JohnTT/ECECapstone2018/Reports/Design Reviews/G07_DR2.pdf

Group 7

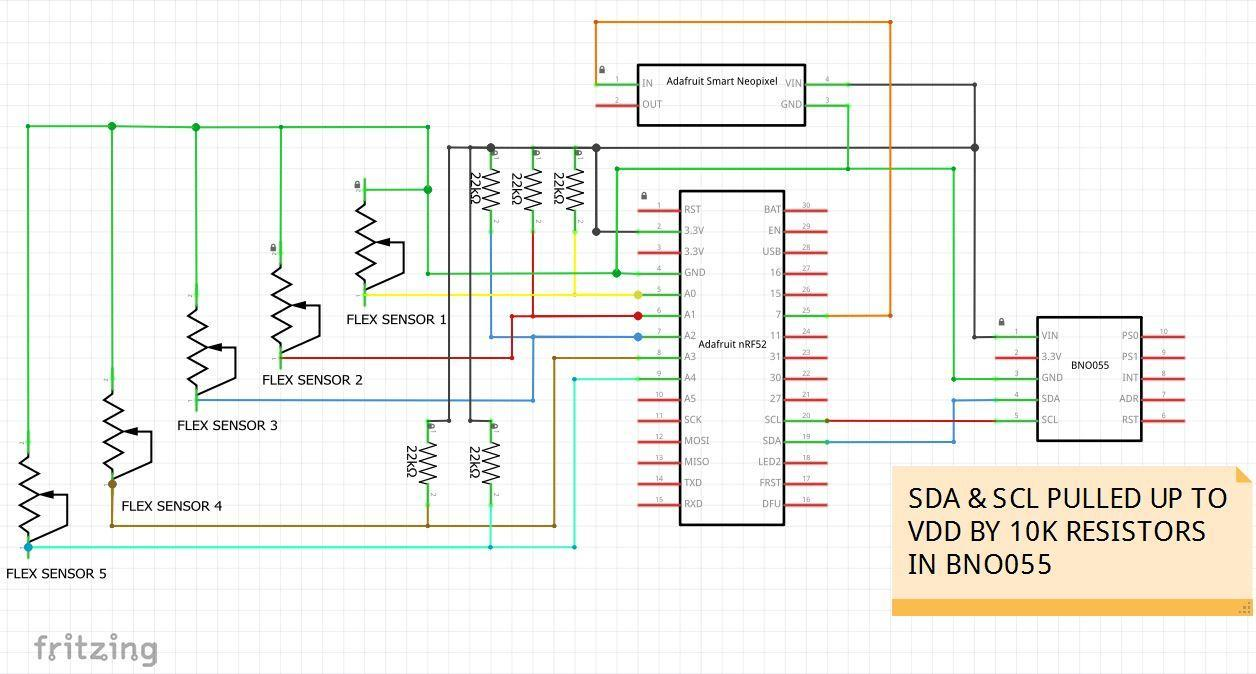
[picture p1: figure]

1

Air Mouse: Wireless translation of hand gestures into two and three-dimensional mouse movements

Summary of Progress

The goal of this project is to make a wearable glove that connects as a mouse to any computer, laptop or cell phone device that supports the Bluetooth 4.0 Low Energy Standard. The first step in the design process was to create a general layout of the components showing their connections to the microcontroller. Figure 1 shows the electrical schematic design. The team tested and studied the ordered hardware components to finalize the mechanisms of each feature on the Air Mouse. The scope of the project includes the wireless transmission of data which the Feather nRF52 Bluefruit LE board satisfies since it contains a Bluetooth transceiver.

Figure 1 Electrical Schematic for Air Mouse

The BNO055 was mounted on a breadboard and tested to record the angular displacement due to movement away from the calibrated start position. It uses three triple-axis sensors: an accelerometer, a gyroscope, and a magnetometer. The BNO055 filters and synthesizes the sensor data on its built in microprocessor which runs a fusion algorithm to give the relative orientation as a vector of three Euler angles. We selected the return in the form of Euler angles, since it is the easiest to visualize and manipulate. The sensor interfaces with nRF52 over I²C serial communication and the nRF52 streams the data to the computer over Bluetooth. The relative position is taken and converted to cursor speed and direction. For testing purposes, we used a flex sensor to set the start position of the breadboard. This was stored in the memory of the nRF52. Updated Euler angles are continually read from the BNO055 and the deviation of the updated angle from the starting angle returns the relative position of the breadboard. Figure 2 shows the resulting angles (+/-α) based on hand movements in the x-y plane.

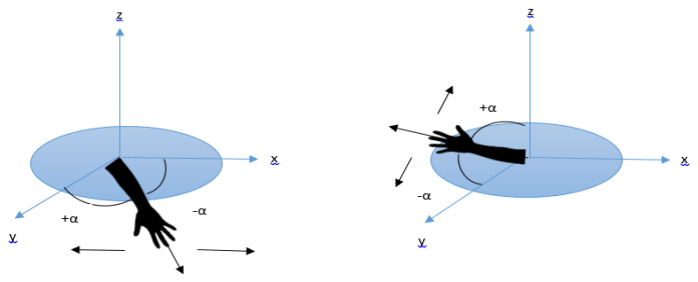
[picture p2: figure]

2

Figure 2 Movement of hand on x-y plane

The flex sensors allow for the mouse clicks by measuring the change in resistance due to bending the sensor. The sensors were measured by Hammed and Ibrahim using a digital multimeter. In their relaxed state, the sensors have a minimum resistance of 50 kΩ and a maximum flexion resistance of 224 kΩ. The change in resistance is communicated with the microcontroller in the form of voltage changes that are detected by the microcontroller on the analog pins 1 and 2. The measured voltages are divided into set thresholds to determine the level of flexion. This allows the flex sensors to aid in three dimensional applications as well such as a grabbing action. In addition to the flex sensors, the pressure sensitive sheets were also tested as an alternative mouse clicking action specifically designed for people with Carpal Tunnel syndrome. The sheets work on the same resistance change principle as the flex sensors. The relaxed state resistance of the sheets was measured on the multimeter to be 0.24 kΩ with a maximum of 8.4 kΩ depending on the pressure applied. .

The portable power source requirement is fulfilled in the form of a 3.7V LiPo Battery Cell which connects to a RGB Smart Neopixel used to display the battery status. Using the current discharge curve of the battery specified on the data sheet, an arbitrary color code was developed by Simran to display the remaining battery life for the Airmouse. The internal vbat pin on the microcontroller is constantly read to get the ADC readings ranging from 0 to 300mV with a 12 bit resolution. The vbat pin also has a resistor voltage divider that is taken into account to get the LiPo voltage readings in mV. The readings are further divided into arbitrary levels. The neopixels change color to inform the user each time the voltage and, hence, the battery level drops below those thresholds. The battery life specifications and optimization can be further worked on as the prototype develops.

Summary of Changes

Our current design uses a flex sensor on the top and pressure sensitive sheets on the bottom of each finger. Because these sensors are enough to perform multiple tasks of clicking as well as scrolling, we decided to remove the joystick to stay within space/weight constraints. The joystick was initially supposed to allow scrolling action.

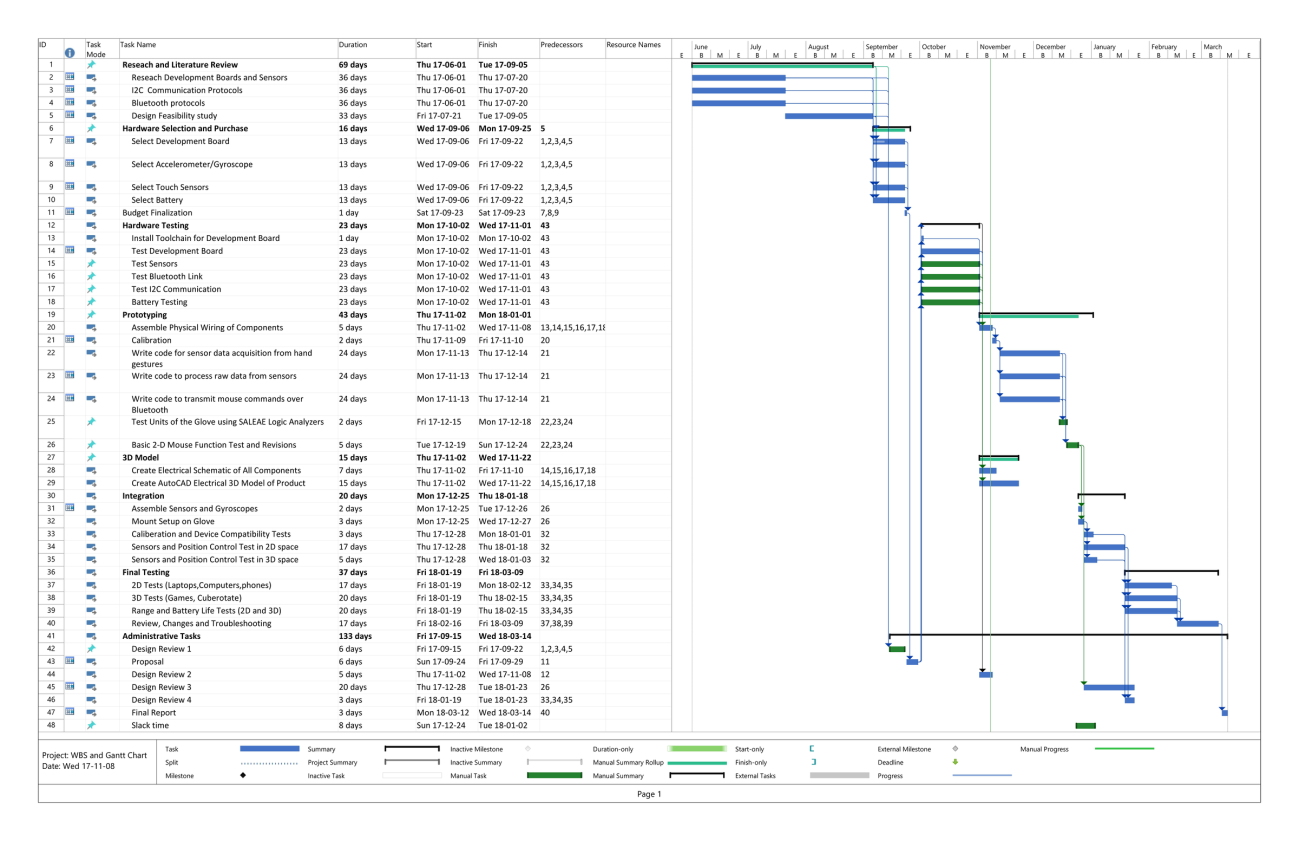
[picture p3: figure]

3

Schedule and Updated Gantt Chart

The team progress and the Gantt Chart tasks were largely in line with each other. The schedule was modified to include slack time in winter from December 24, 2017 to January 2, 2018 to account for winter holidays. This reduces the time for sensor data acquisition, processing of raw data and transmission code development from 31 to 24 days which we deem achievable. This also mandates the completion of basic two dimensional mouse features testing to be completed by December 24, 2017.
