JohnTT/ECECapstone2018/Reports/Design Reviews/G07_DR2Slide_v2.pdf

# AIRMOUSE

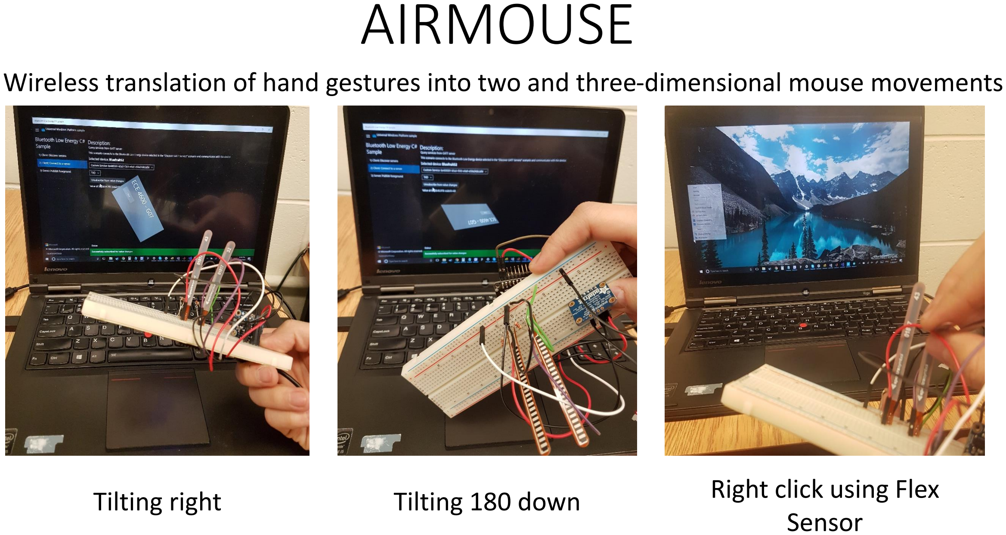
[picture p4: page 1]

Wireless translation of hand gestures into two and three-dimensional mouse movements

Tilting right | Tilting 180 down | Right click using Flex Sensor
