JohnTT/ECECapstone2018/Reports/Design Reviews/G07_DR3_V9.pdf

G07 - Air Mouse: Wireless translation of hand gestures into two and three-dimensional mouse movements

### 1.0 Summary of Progress towards Integration

The goal of this project is to make a wearable glove that connects as a mouse to any computer, laptop or cell phone device that supports the Bluetooth 4.0 Low Energy Standard. In line with the pre-established Gantt chart schedule, the project is in the integration stage.

A diagram was created to show the position of each component on a right-hand glove, and then the tested sub-systems were transferred from the breadboard onto the glove. The glove material was chosen using the following criterion:

- Lightweight (< 50g) to allow for unstrained hand movements.
- Antistatic Fabric to ensure against static electricity buildup.
- Air-permeable to reduce sweating or related discomfort.
A ready-to-wear right-hand glove made of cotton was chosen in standard unisex, medium size, for the prototype.

### 1.1 The layout of the glove was carefully planned and designed as follows:

The BNO055 sensor receives the hand orientation and tilt information based on Euler angle displacement from its initial position. To allow for maximum sensitivity to hand movements and gestures, it is mounted horizontally slightly before the knuckles area.

The Flex sensors are placed on the inner sides of the glove for more flexibility and to reduce the amount of pressure exerted on the fingers. A 33K Ohm resistor is attached in series with each flex sensor for this design, which gives a range of approximately 0.5V, from fully straight to fully flexed when tested. The threshold voltage for the pinky (A0), ring (A1), middle (A2) and index fingers (A3) were set to 1.8V, 2.5V, 2.0V, and 2.9V respectively. The numbers in brackets indicate which corresponding pin each sensor is connected to on the microcontroller. The state of each finger is read by the microcontroller, and flexing and relaxing certain fingers allows the user to perform mouse actions. This allows the microcontroller to distinguish between left and right mouse clicks depending on which finger is flexed. Flexing all fingers at once puts the mouse in scrolling mode.

The Battery is mounted between the thumb finger and wrist area. The Neopixel is placed beside it to indicate the battery life remaining with the intensity of the status indicator lamp. The brightness indicates the power level of the battery, with a green color light displaying a state of maximum charge and red for the minimum. A slider switch was placed close to the battery location for the ease turning the glove on or off. The Bluefruit nRF52 board was positioned such that the micro-USB connector is oriented towards the user for recharging the battery or connection of any external sources.

Circuit Interconnection - This design layout was wired using jumper cable connections among different components for flexibility while testing. The flex sensors are held in place using glue whereas the BNO055 was sewn onto the fabric. The final design circuit connections will be done with conducting thread 316L as specified in our proposal.

### 1.3 First Design Prototype

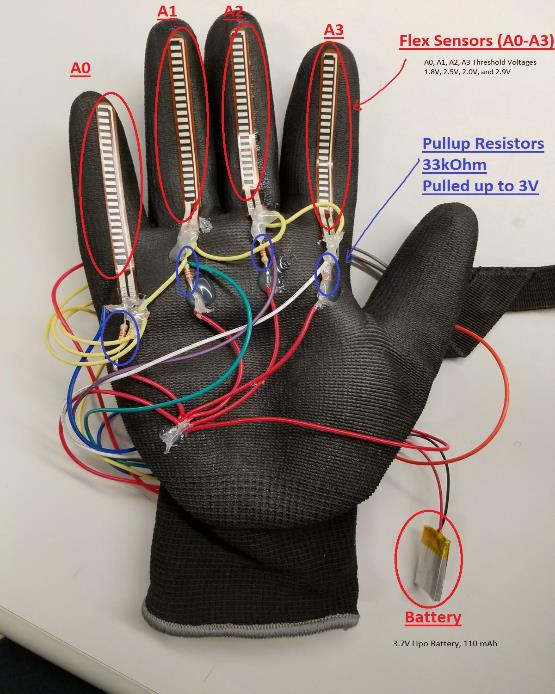
[picture p5: figure]
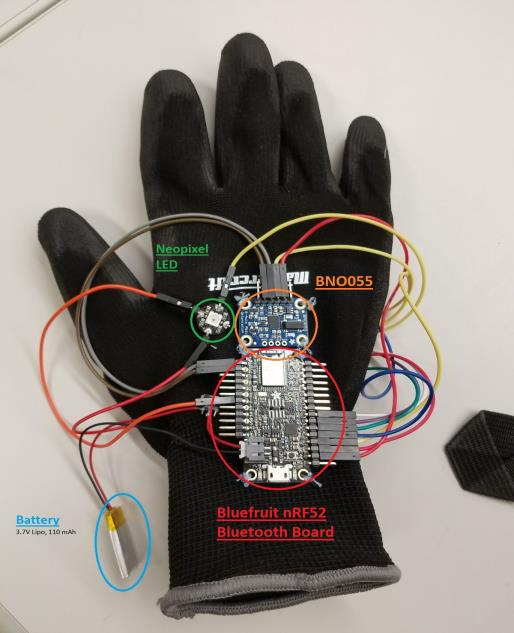
[picture p6: figure]

Figure 1 - Left image shows top view of glove. The image on the right is the bottom view of the glove.

### 2.0 Summary of Changes Made to Design

2.1 The pressure sensitive sheet, which was initially intended as an alternate method for providing mean of control, was removed from the design at this stage. The flex sensors provide better threshold values than the pressure sensitive sheet and was, hence, removed.

2.2 Our initial design was to display three colours that indicated fixed battery range, Green (100%-43%), Yellow (42%-7%), Red (6%-0%). A varying brightness scheme was implemented for each colour to indicate the charge in each range. The brighter the colour, the higher the charge in that range. This change was brought forth to provide the user with a better indication of the battery state of charge as it is visually more incremental than then semi-frequent level to level changes in colour.

2.3 A finite state machine code was implemented to read the state of the flex sensors. This method replaced the previously used polling method which involved polling each flex sensor until it is flexed to perform an action. The finite state method proved to be more efficient as it allowed for an increase in the number of possible functions from 4 to 16.

2.4 The glove design was changed from the initially proposed five flex sensors to four, omitting the thumb finger sensor. The removal was a result of weighing the added capabilities from adding one more flex sensor against the added power draw of the sensor, wires, and the resulting reduced mobility of the thumb. Thus, it was concluded that the minimal added capabilities of placing a flex sensor on the thumb did not outweigh the reduced performance.

### 3.0 Summary of Changes to GANTT Chart

The time allotted for 3D model testing and programming was removed from the Gantt chart to provide more time for the 2D model. The 3D feature was also proposed as optional so the team will look into implementing it once the basic mouse functions are successfully programmed.

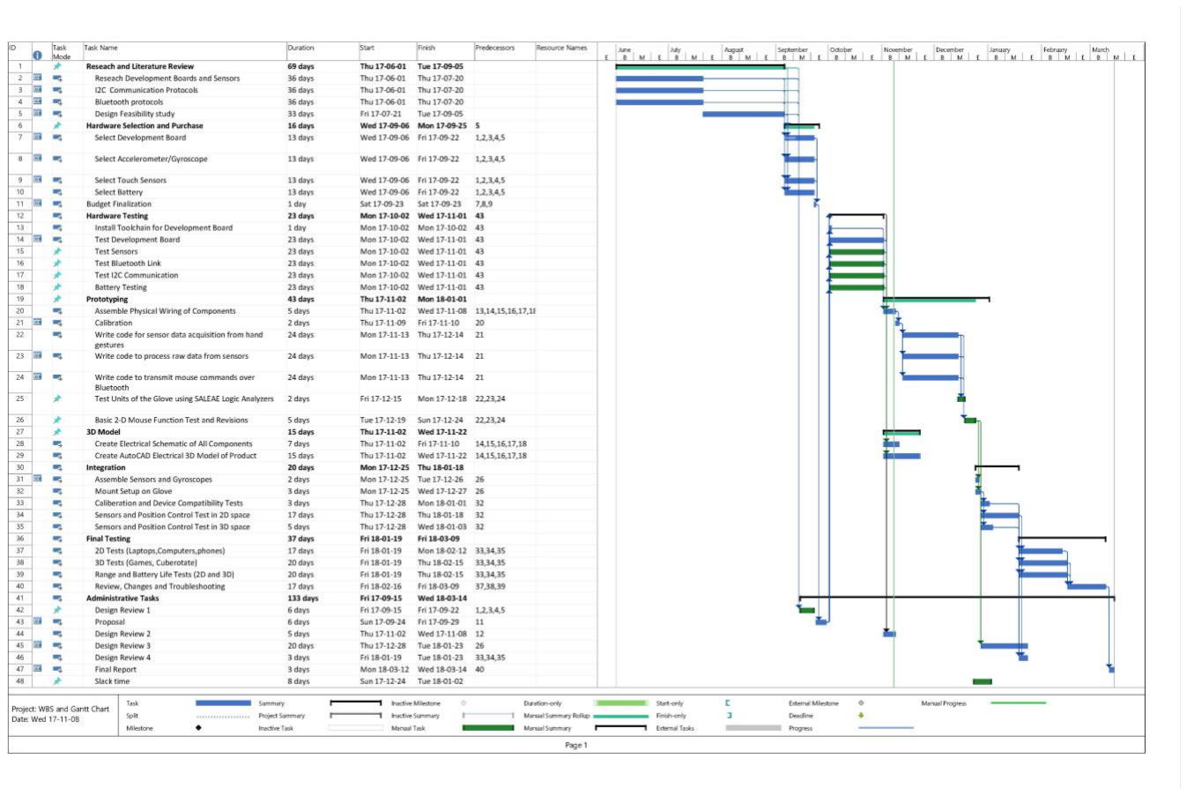
[picture p7: figure]
