JohnTT/ECECapstone2018/Reports/Design Reviews/G07_DR4SlideV5.pdf

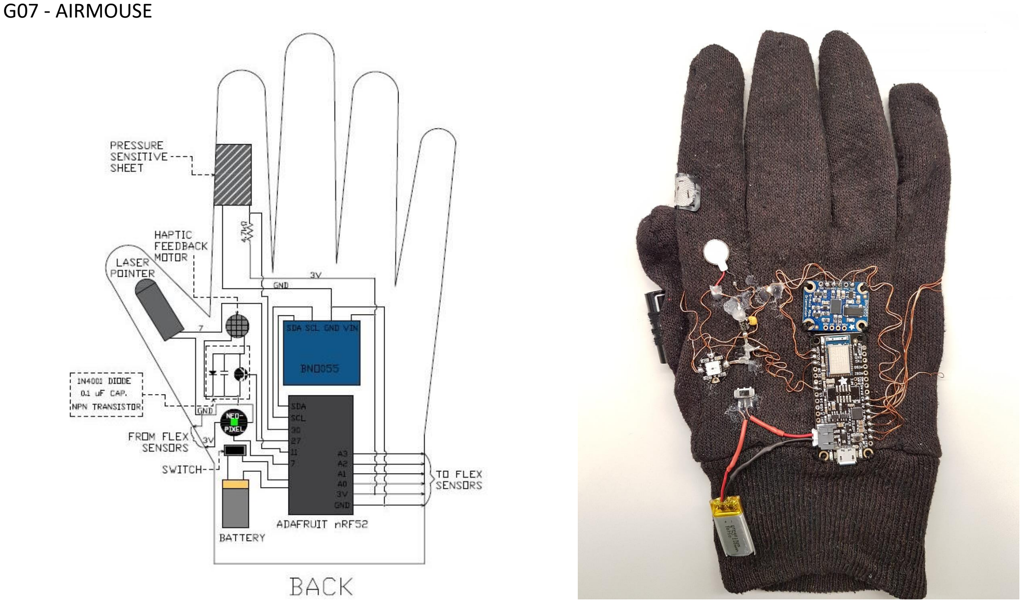
[picture p31: page 1]

G07 - AIRMOUSE

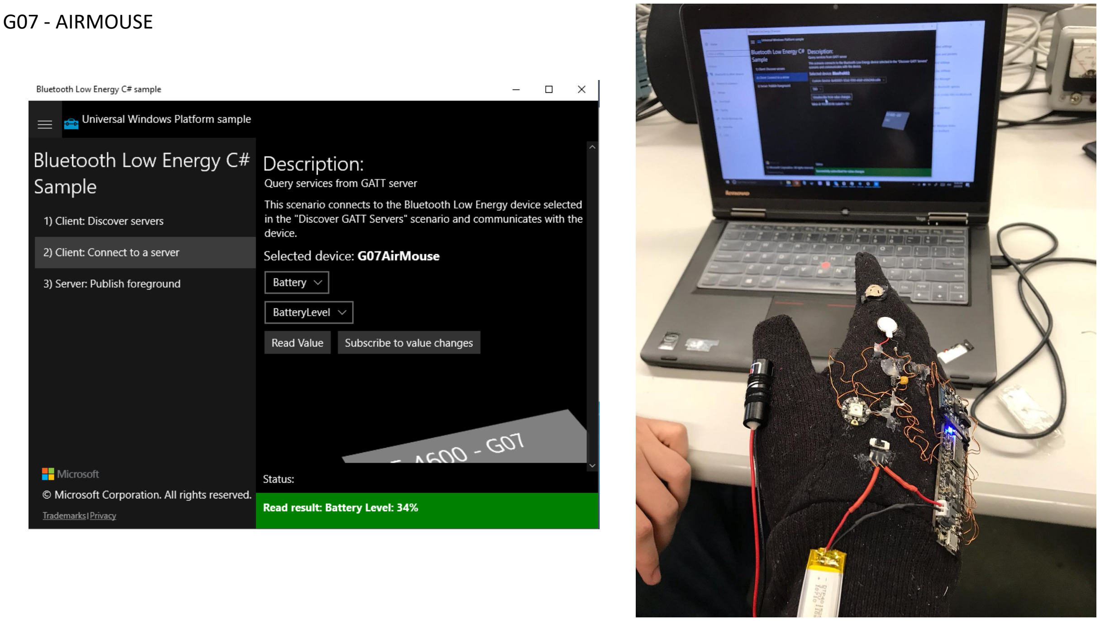
[picture p32: page 2]

G07 - AIRMOUSE
