JohnTT/ECECapstone2018/Reports/Design Reviews/G07_DR3SlideV3.pdf

# DESIGN PROGRESS

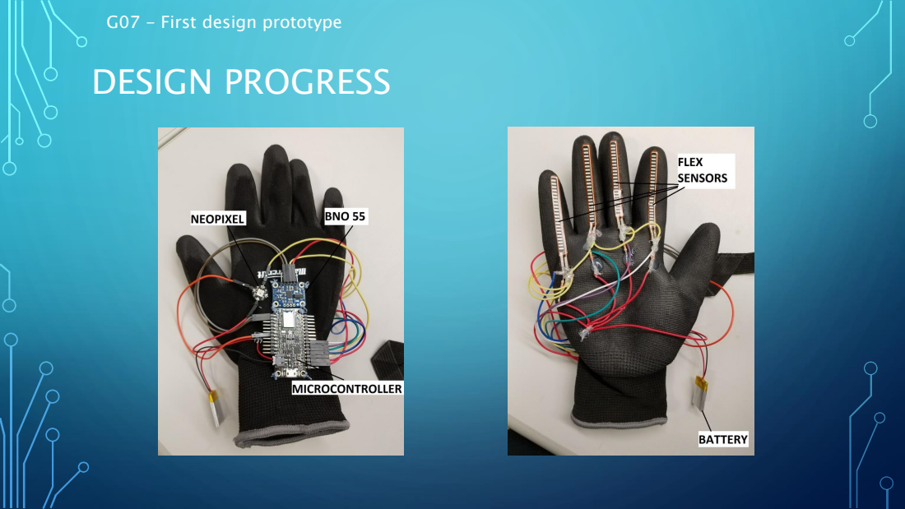
[picture p33: page 1]

G07 - First design prototype

# CHANGES TO DESIGN

## State Machine used for

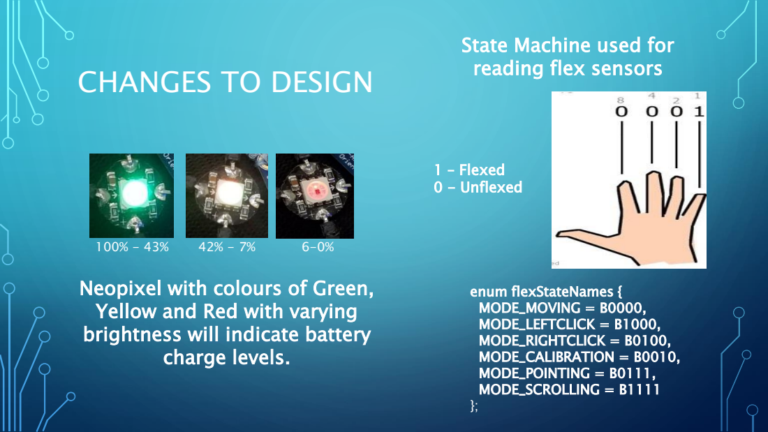
[picture p34: page 2]
charge levels.; enum flexStateNames { MODE_MOVING = B0000, MODE_LEFTCLICK = B1000, MODE_RIGHTCLICK = B0100, MODE_CALIBRATION = B0010, MODE_POINTING = B0111, MODE_SCROLLING = B1111; 1 – Flexed 0 - Unflexed

reading flex sensors

Neopixel with colours of Green,
Yellow and Red with varying
brightness will indicate battery
