JohnTT/ECECapstone2018/(commit log)

2017-09-11 Add buttons and scrolling
2017-09-15 Added moving with sensor
2017-11-08 switch to quaternion
2018-03-22 remove Serial Println increases speed
